Fabrizio721/pneumatic-levitation-pid/(commit log)

2026-09-14 Add Arduino PID controller implementation
2026-09-14 Add MATLAB pneumatic plant model
2026-09-14 Add MATLAB PID controller design
